janelia-kicad/high_power_switch_controller_5x3/README.org

#+TITLE: high_power_switch_controller_5x3
#+AUTHOR: Peter Polidoro
#+EMAIL: peter@polidoro.io

* Repository Information
  - Author :: Peter Polidoro
  - License :: Open-Source Hardware
