janelia-kicad/high_power_switch_controller_5x3/schematic/high_power_switch_controller_5x3.pdf

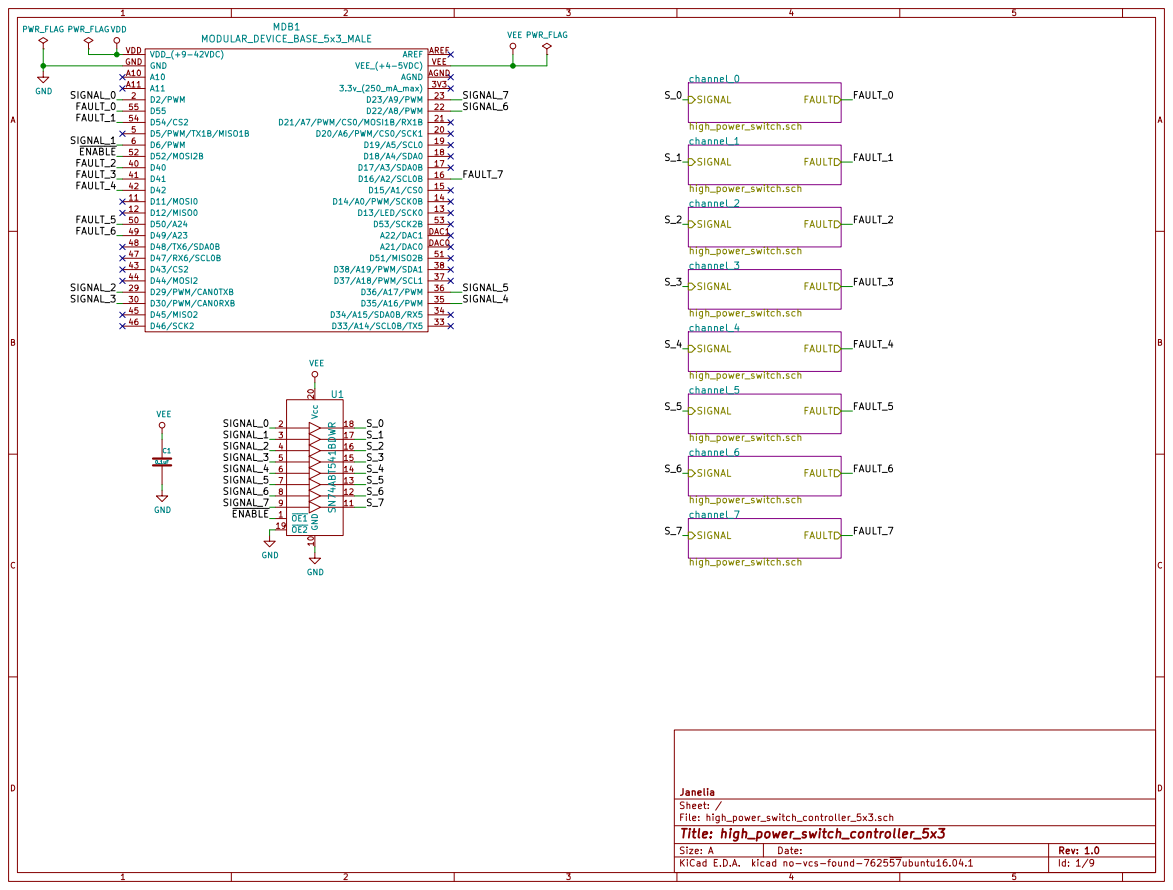
[picture p1: page 1]

File: high_power_switch_controller_5x3.sch Sheet: / Janelia

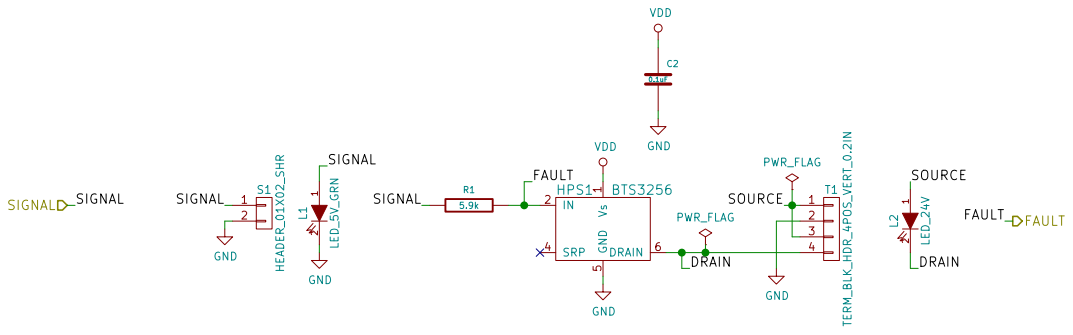
[picture p2: page 2]

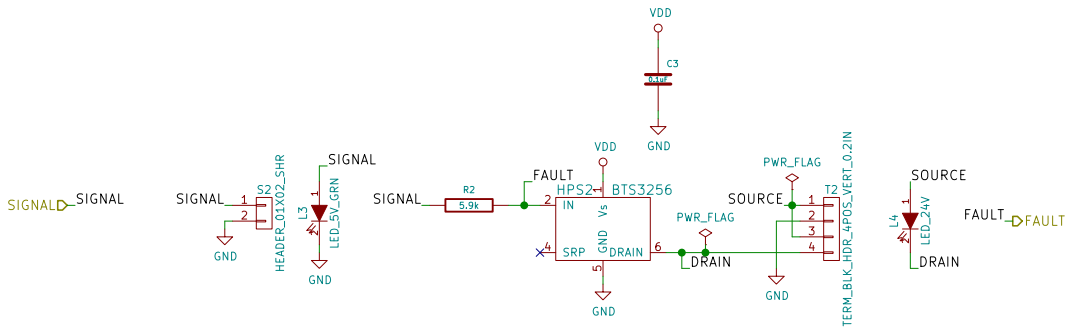
[picture p3: page 3]

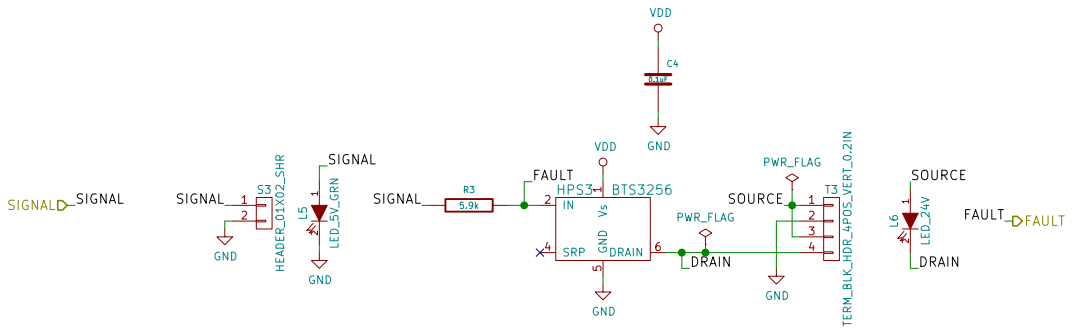
[picture p4: page 4]

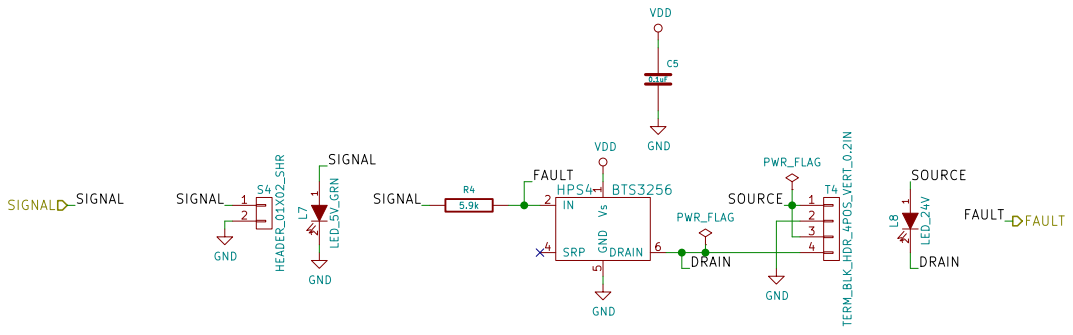
[picture p5: page 5]

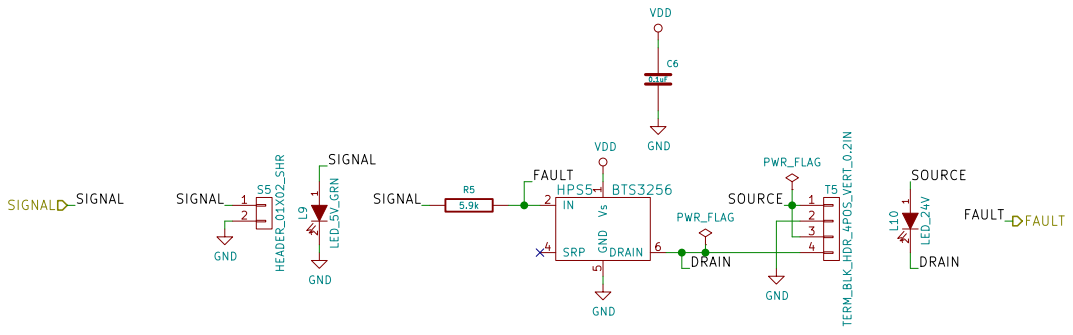
[picture p6: page 6]

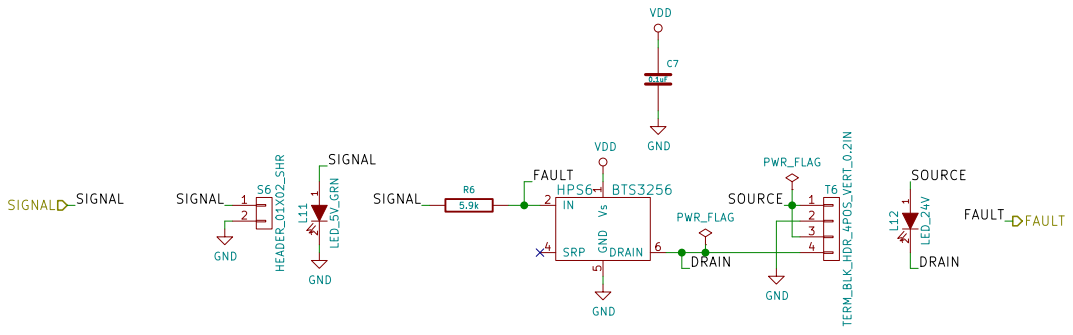
[picture p7: page 7]

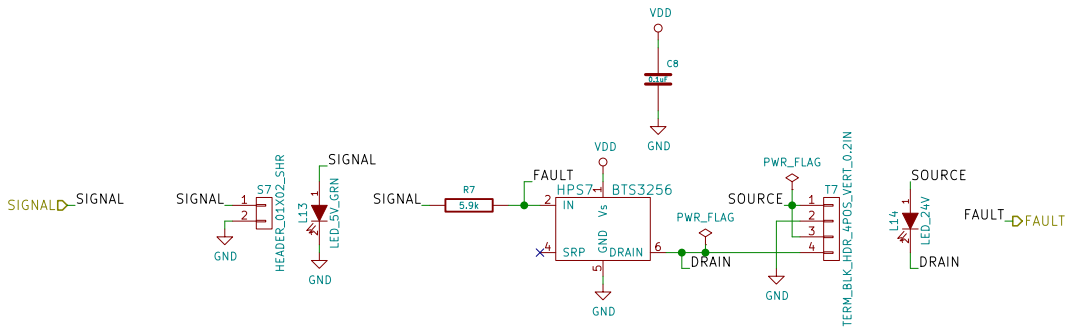
[picture p8: page 8]

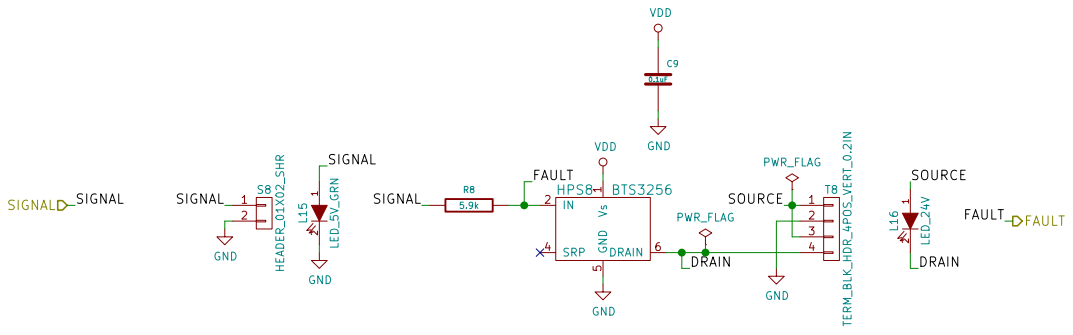
[picture p9: page 9]
