janelia-kicad/high_power_switch_controller_5x3/(commit log)

2017-02-09 Initial commit.
    [bom_pcb.csv, bom_pcb_add.csv, digikey_order_pcb.csv, hitfet_controller_5x3.kicad_pcb, hitfet_controller_5x3.sch]
2017-02-09 Added graphic lines.
    [hitfet_controller_5x3.kicad_pcb]
2017-02-09 hitfet -> high_power_switch.
    [high_power_switch_controller_5x3.kicad_pcb, high_power_switch_controller_5x3.sch]
2017-02-09 Added PG-TO252-5-11 footprint.
2017-02-09 Updated footprint.
2017-02-09 Progress towards v1.0.
    [high_power_switch_controller_5x3.sch]
2017-02-10 More progress.
    [high_power_switch_controller_5x3.sch]
2017-02-10 Finished one channel.
    [high_power_switch_controller_5x3.sch]
2017-02-13 Finished version 1.0.
    [bom_pcb.csv, bom_pcb_add.csv, digikey_order.csv, digikey_order_pcb.csv, digikey_order_pcb_add.csv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]
2017-09-13 Updated 0.1uF capacitors.
    [bom_pcb.csv, digikey_order.csv, digikey_order_pcb.csv, high_power_switch.sch, high_power_switch_controller_5x3.sch]
2018-01-08 Updated to v4.
    [high_power_switch.sch, high_power_switch_controller_5x3.sch]
2018-08-12 Marked extra Teensy 3.5 Pins.
2021-09-21 Remove ignored files
    [high_power_switch_controller_5x3.dsn]
